sokrasins/boot-selector/README.md

# Boot Selector
 
 Choose your booting OS, now with more RP2040!

 Inspired by
