sokrasins/boot-selector/pcb/boot_main/boot_main.kicad_pcb

## KiCad design pcb/boot_main/boot_main.kicad_pcb (2024-08-22)

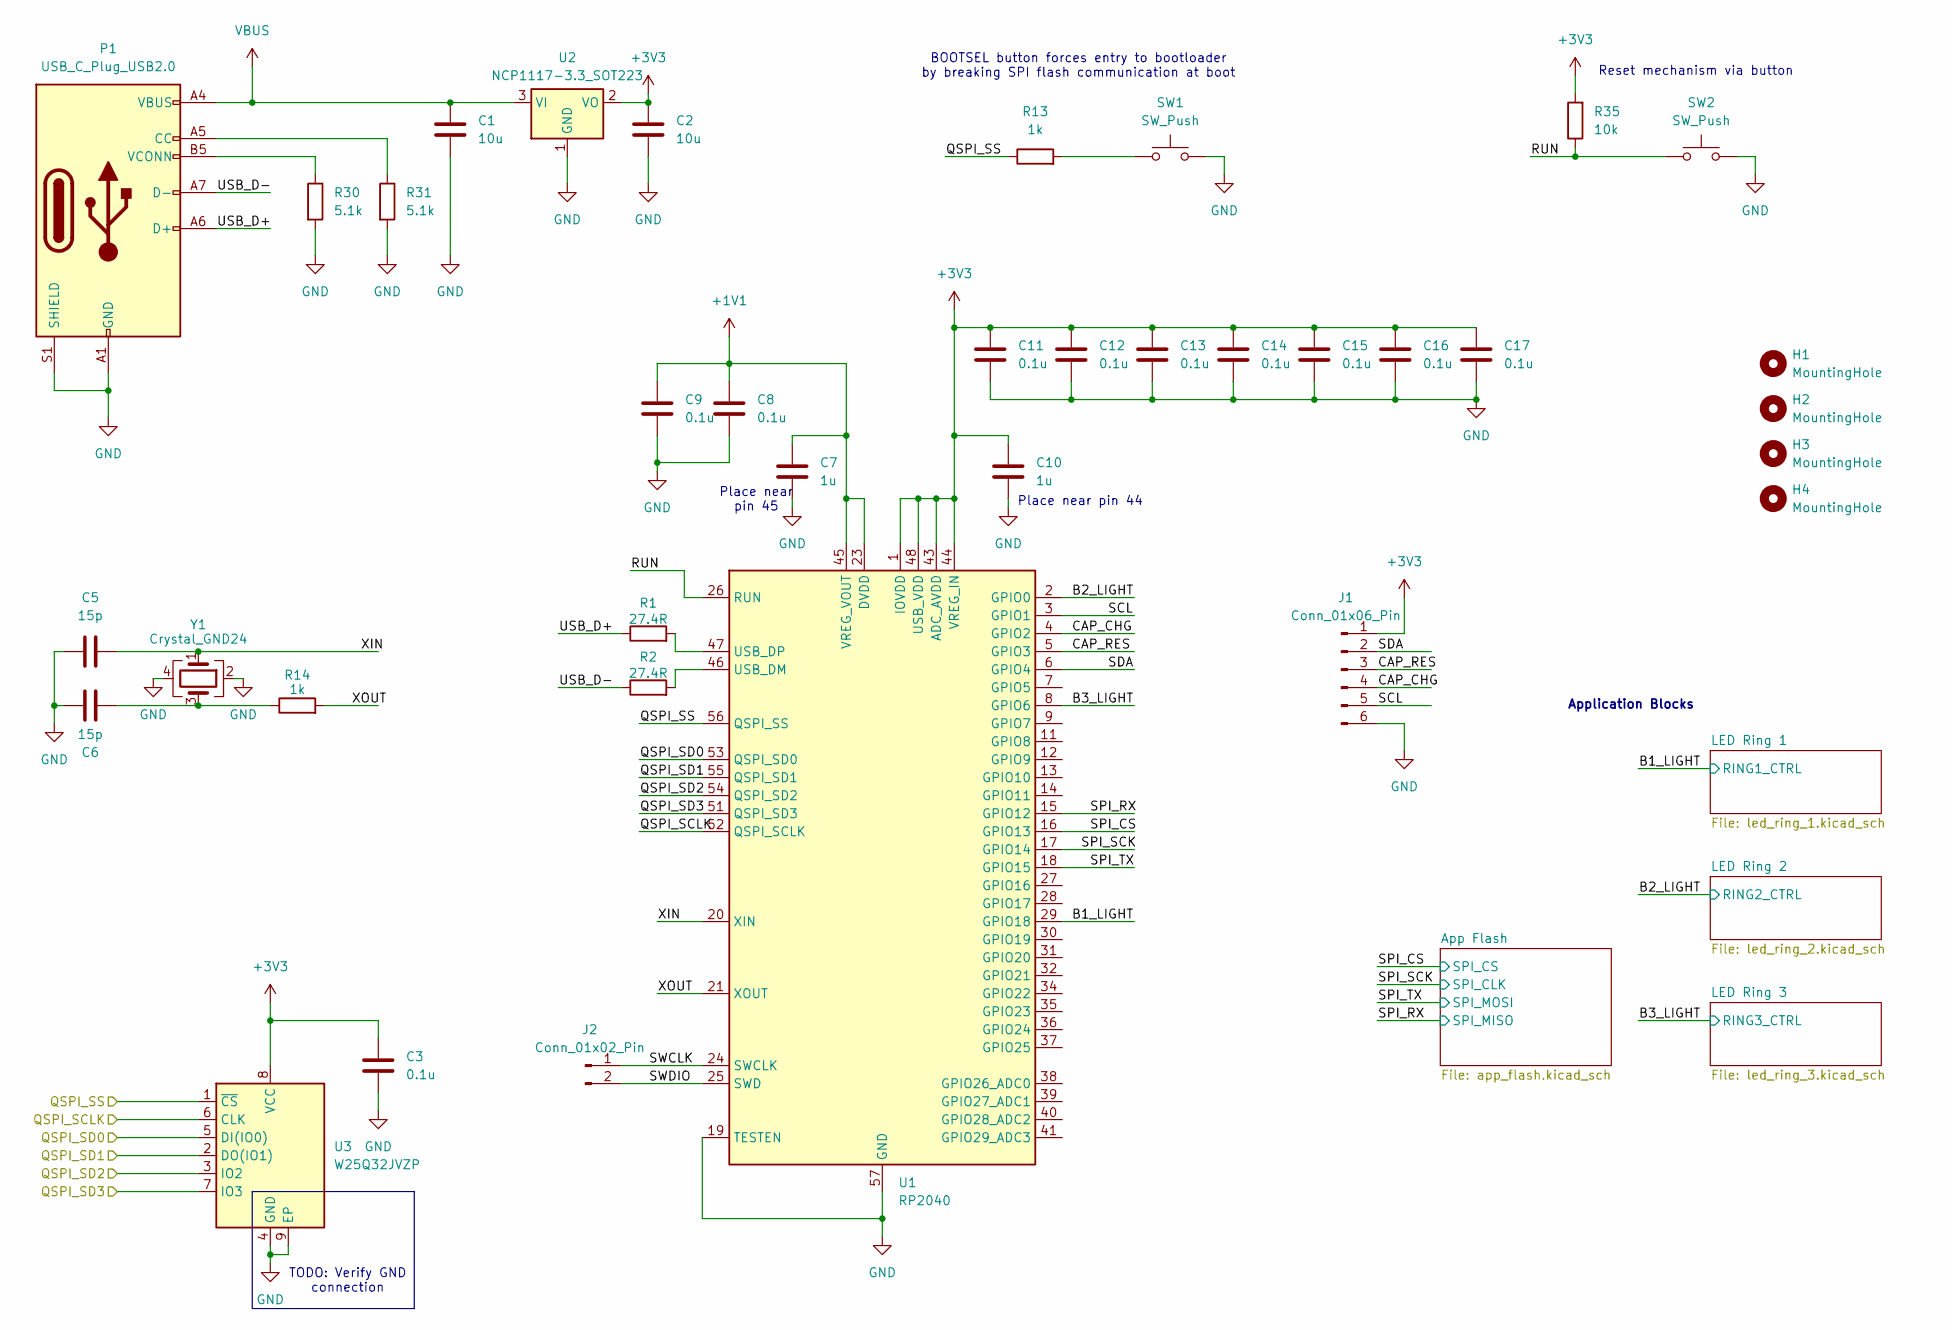
[picture p1: schematic boot_main.kicad_sch]

Parts:
C1, C2: 10u; C_0603_1608Metric
C3: 0.1u; C_0603_1608Metric
C5, C6: 15p; C_0402_1005Metric
C7, C10: 1u; C_0402_1005Metric
C8, C9, C11, C12, C13, C14, C15, C16, C17: 0.1u; C_0402_1005Metric
H1, H2, H3, H4: MountingHole; MountingHole_3.2mm_M3
J1: Conn_01x06_Pin; Hirose_FH12-6S-0.5SH_1x06-1MP_P0.50mm_Horizontal
J2: Conn_01x02_Pin; PinHeader_1x02_P2.54mm_Vertical
P1: USB_C_Plug_USB2.0; USB_C_Receptacle_GCT_USB4115-03-C
R1, R2: 27.4R; R_0402_1005Metric
R13: 1k; R_0603_1608Metric
R14: 1k; R_0402_1005Metric
R30, R31: 5.1k; R_0402_1005Metric
R35: 10k; R_0603_1608Metric
SW1, SW2: SW_Push; SW_Push_1P1T_NO_6x6mm_H9.5mm
U1: RP2040; QFN-56-1EP_7x7mm_P0.4mm_EP3.2x3.2mm
U2: NCP1117-3.3_SOT223; SOT-223-3_TabPin2
U3: W25Q32JVZP; WSON-8-1EP_6x5mm_P1.27mm_EP3.4x4.3mm
Y1: Crystal_GND24; Crystal_SMD_3225-4Pin_3.2x2.5mm

Connections:
+1V1: C7.1, C8.1, C9.1, U1.23 (DVDD), U1.45 (VREG_VOUT), U1.50 (DVDD)
+3V3: C2.1, C3.1, C10.1, C11.1, C12.1, C13.1, C14.1, C15.1, C16.1, C17.1, J1.1, R35.2, U1.1 (IOVDD), U1.10 (IOVDD), U1.22 (IOVDD), U1.33 (IOVDD), U1.42 (IOVDD), U1.43 (ADC_AVDD), U1.44 (VREG_IN), U1.48 (USB_VDD), U1.49 (IOVDD), U2.2 (VO), U3.8 (VCC); also elsewhere on the board
/B1_LIGHT: U1.29 (GPIO18); also elsewhere on the board
/B2_LIGHT: U1.2 (GPIO0); also elsewhere on the board
/B3_LIGHT: U1.8 (GPIO6); also elsewhere on the board
/CAP_CHG: J1.4, U1.4 (GPIO2)
/CAP_RES: J1.3, U1.5 (GPIO3)
/QSPI_SCLK: U1.52 (QSPI_SCLK), U3.6 (CLK)
/QSPI_SD0: U1.53 (QSPI_SD0), U3.5 (DI(IO0))
/QSPI_SD1: U1.55 (QSPI_SD1), U3.2 (DO(IO1))
/QSPI_SD2: U1.54 (QSPI_SD2), U3.3 (IO2)
/QSPI_SD3: U1.51 (QSPI_SD3), U3.7 (IO3)
/QSPI_SS: R13.1, U1.56 (QSPI_SS), U3.1 (~CS)
/RUN: R35.1, SW2.1, U1.26 (RUN)
/SCL: J1.5, U1.3 (GPIO1)
/SDA: J1.2, U1.6 (GPIO4)
/SPI_CS: U1.16 (GPIO13); also elsewhere on the board
/SPI_RX: U1.15 (GPIO12); also elsewhere on the board
/SPI_SCK: U1.17 (GPIO14); also elsewhere on the board
/SPI_TX: U1.18 (GPIO15); also elsewhere on the board
/SWCLK: J2.1, U1.24 (SWCLK)
/SWDIO: J2.2, U1.25 (SWD)
/USB_D+: P1.A6 (D+), R1.1
/USB_D-: P1.A7 (D-), R2.1
/XIN: C5.2, U1.20 (XIN), Y1.1
/XOUT: R14.2, U1.21 (XOUT)
GND: C1.2, C2.2, C3.2, C5.1, C6.1, C7.2, C8.2, C9.2, C10.2, C11.2, C12.2, C13.2, C14.2, C15.2, C16.2, C17.2, J1.6, P1.A1 (GND), P1.A12 (GND), P1.B1 (GND), P1.B12 (GND), P1.S1 (SHIELD), R30.2, R31.2, SW1.2, SW2.2, U1.19 (TESTEN), U1.57 (GND), U2.1 (GND), U3.4 (GND), U3.9 (EP), Y1.2, Y1.4; also elsewhere on the board
unnamed: C6.2, R14.1, Y1.3
unnamed: P1.A5 (CC), R31.1
unnamed: P1.B5 (VCONN), R30.1
unnamed: R13.2, SW1.1
unnamed: R2.2, U1.46 (USB_DM)
unnamed: R1.2, U1.47 (USB_DP)
VBUS: C1.1, P1.A4 (VBUS), P1.A9 (VBUS), P1.B4 (VBUS), P1.B9 (VBUS), U2.3 (VI); also elsewhere on the board

Notes on the sheet:
BOOTSEL button forces entry to bootloader by breaking SPI flash communication at boot
TODO: Verify GND connection
Place near pin 44
Place near pin 45
Reset mechanism via button
Application Blocks

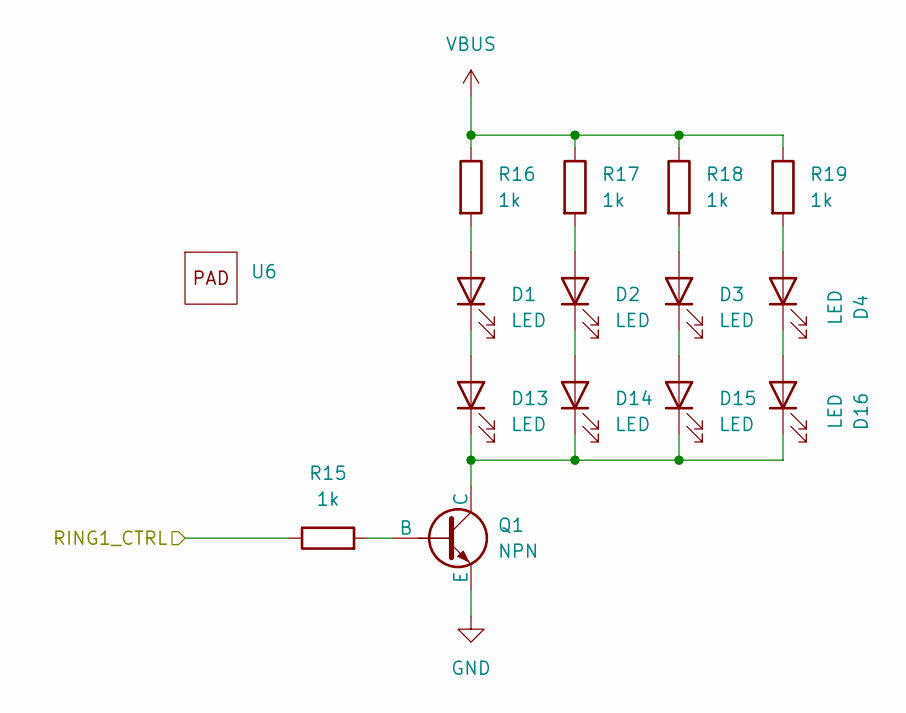
[picture p2: schematic led_ring_1.kicad_sch]

Parts:
D1, D2, D3, D4, D13, D14, D15, D16: LED; LED_1206_3216Metric
Q1: NPN; SOT-323_SC-70
R15, R16, R17, R18, R19: 1k; R_0603_1608Metric
U6: square_20x20mm_guide

Connections:
/B1_LIGHT: R15.1; also elsewhere on the board
GND: Q1.3 (E); also elsewhere on the board
unnamed: D1.2 (A), R16.2
unnamed: D1.1 (K), D13.2 (A)
unnamed: D2.2 (A), R17.2
unnamed: D3.2 (A), R18.2
unnamed: D4.2 (A), R19.2
unnamed: D13.1 (K), D14.1 (K), D15.1 (K), D16.1 (K), Q1.1 (C)
unnamed: D2.1 (K), D14.2 (A)
unnamed: D3.1 (K), D15.2 (A)
unnamed: D4.1 (K), D16.2 (A)
unnamed: Q1.2 (B), R15.2
VBUS: R16.1, R17.1, R18.1, R19.1; also elsewhere on the board

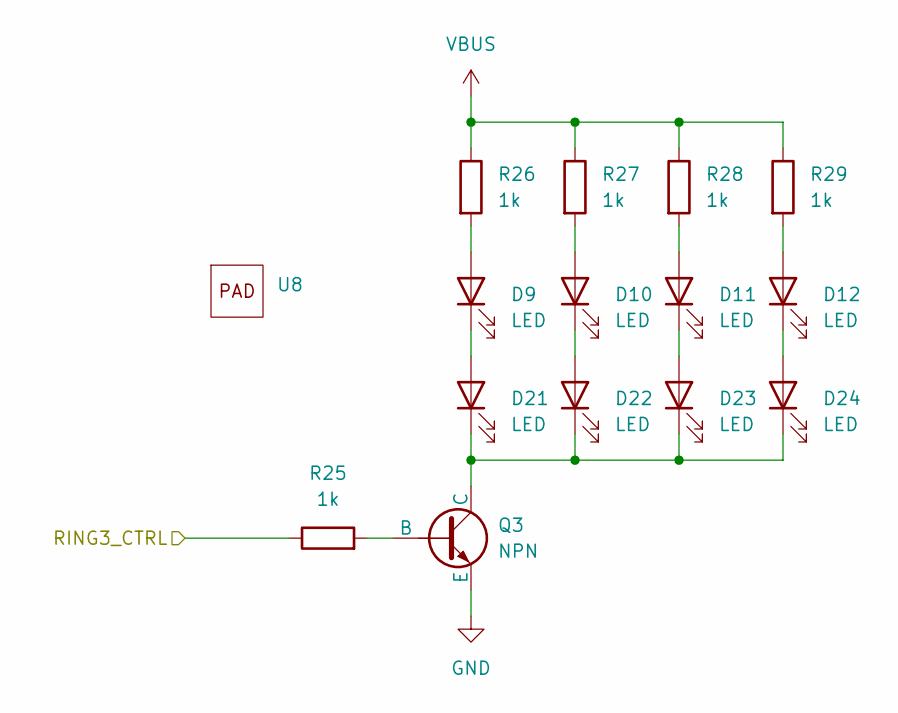
[picture p3: schematic led_ring_3.kicad_sch]

Parts:
D9, D10, D11, D12, D21, D22, D23, D24: LED; LED_1206_3216Metric
Q3: NPN; SOT-323_SC-70
R25, R26, R27, R28, R29: 1k; R_0603_1608Metric
U8: square_20x20mm_guide

Connections:
/B3_LIGHT: R25.1; also elsewhere on the board
GND: Q3.3 (E); also elsewhere on the board
unnamed: D9.2 (A), R26.2
unnamed: D10.2 (A), R27.2
unnamed: D10.1 (K), D22.2 (A)
unnamed: D11.2 (A), R28.2
unnamed: D11.1 (K), D23.2 (A)
unnamed: D12.2 (A), R29.2
unnamed: D12.1 (K), D24.2 (A)
unnamed: D9.1 (K), D21.2 (A)
unnamed: D21.1 (K), D22.1 (K), D23.1 (K), D24.1 (K), Q3.1 (C)
unnamed: Q3.2 (B), R25.2
VBUS: R26.1, R27.1, R28.1, R29.1; also elsewhere on the board

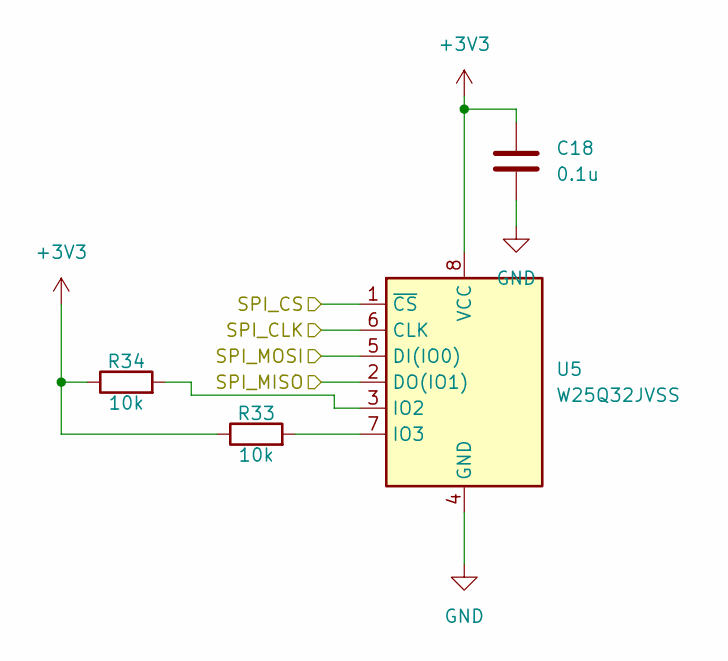
[picture p4: schematic app_flash.kicad_sch]

Parts:
C18: 0.1u; C_0603_1608Metric
R33, R34: 10k; R_0603_1608Metric
U5: W25Q32JVSS; SOIC-8_5.23x5.23mm_P1.27mm

Connections:
+3V3: C18.1, R33.1, R34.1, U5.8 (VCC); also elsewhere on the board
/SPI_CS: U5.1 (~CS); also elsewhere on the board
/SPI_RX: U5.2 (DO(IO1)); also elsewhere on the board
/SPI_SCK: U5.6 (CLK); also elsewhere on the board
/SPI_TX: U5.5 (DI(IO0)); also elsewhere on the board
GND: C18.2, U5.4 (GND); also elsewhere on the board
unnamed: R34.2, U5.3 (IO2)
unnamed: R33.2, U5.7 (IO3)

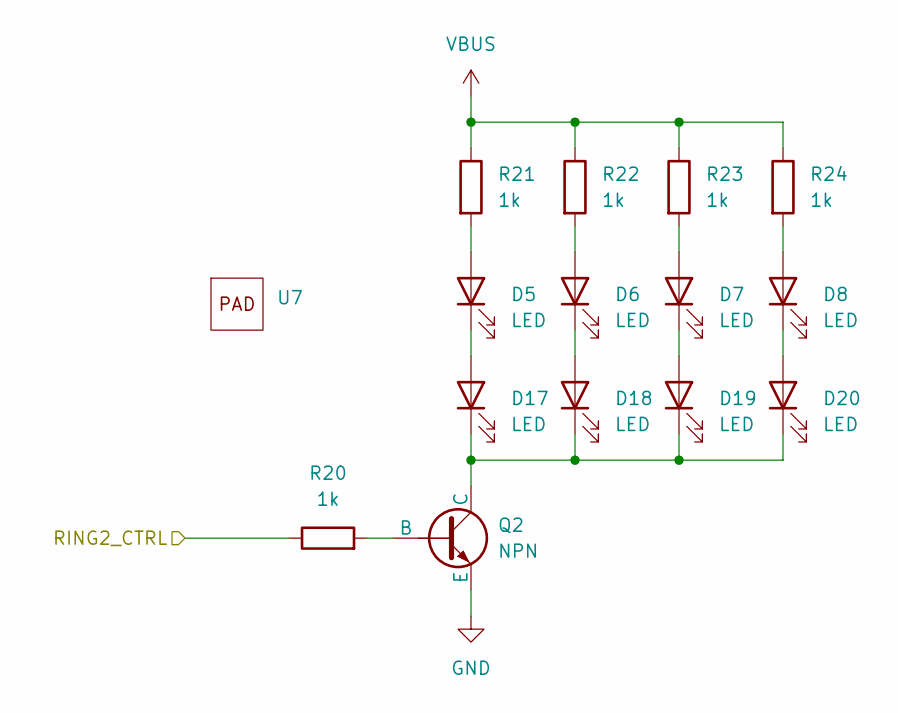
[picture p5: schematic led_ring_2.kicad_sch]

Parts:
D5, D6, D7, D8, D17, D18, D19, D20: LED; LED_1206_3216Metric
Q2: NPN; SOT-323_SC-70
R20, R21, R22, R23, R24: 1k; R_0603_1608Metric
U7: square_20x20mm_guide

Connections:
/B2_LIGHT: R20.1; also elsewhere on the board
GND: Q2.3 (E); also elsewhere on the board
unnamed: D5.2 (A), R21.2
unnamed: D6.2 (A), R22.2
unnamed: D7.2 (A), R23.2
unnamed: D8.2 (A), R24.2
unnamed: D5.1 (K), D17.2 (A)
unnamed: D17.1 (K), D18.1 (K), D19.1 (K), D20.1 (K), Q2.1 (C)
unnamed: D6.1 (K), D18.2 (A)
unnamed: D7.1 (K), D19.2 (A)
unnamed: D8.1 (K), D20.2 (A)
unnamed: Q2.2 (B), R20.2
VBUS: R21.1, R22.1, R23.1, R24.1; also elsewhere on the board

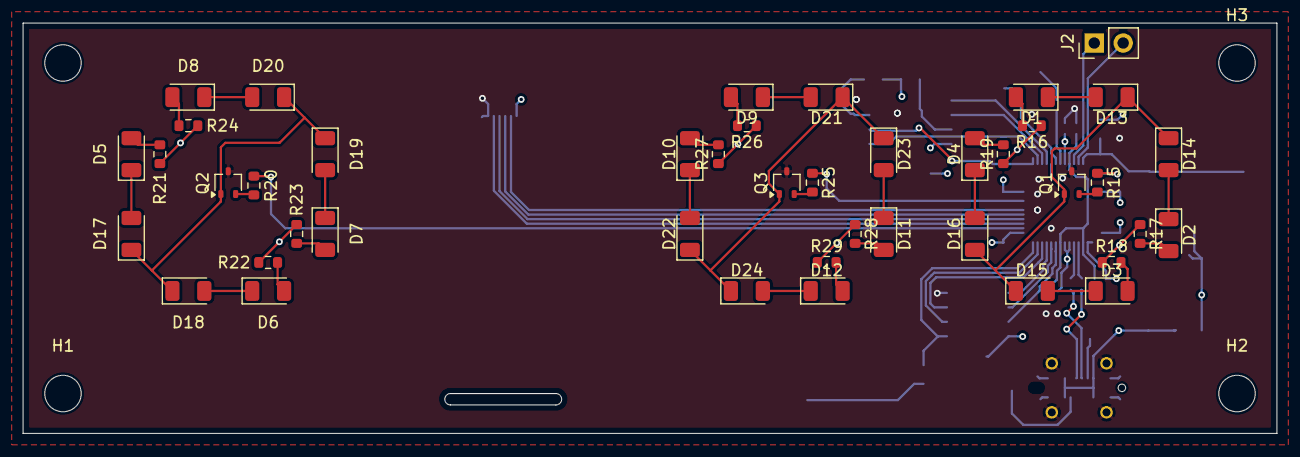
[picture p6: board boot_main.kicad_pcb from above]

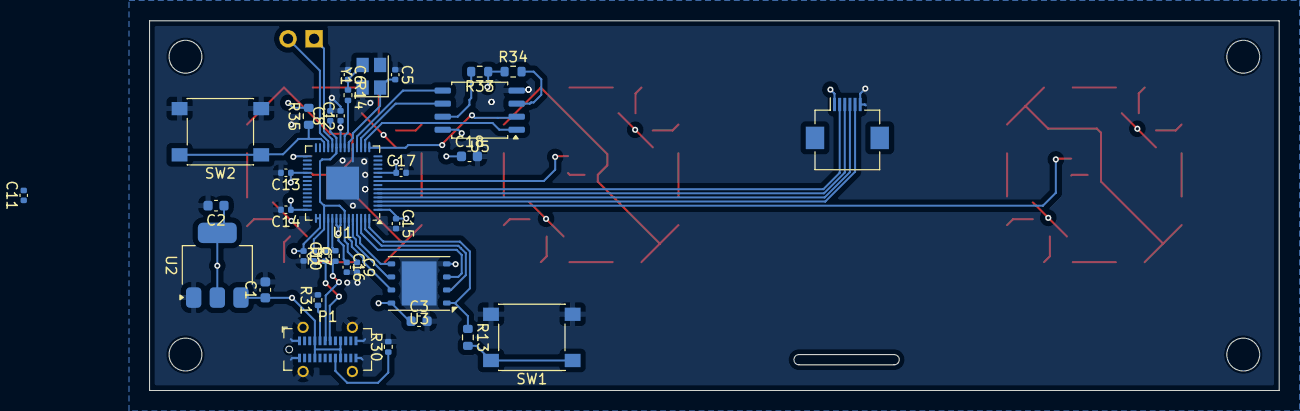
[picture p7: board boot_main.kicad_pcb from below]

Board: 4 copper layers, 110.0 x 36.0 mm, 85 parts (35 on the bottom side), 66 nets.
