sokrasins/boot-selector/pcb/boot_panel/boot_panel.kicad_pcb

## KiCad design pcb/boot_panel/boot_panel.kicad_pcb (2024-08-07)

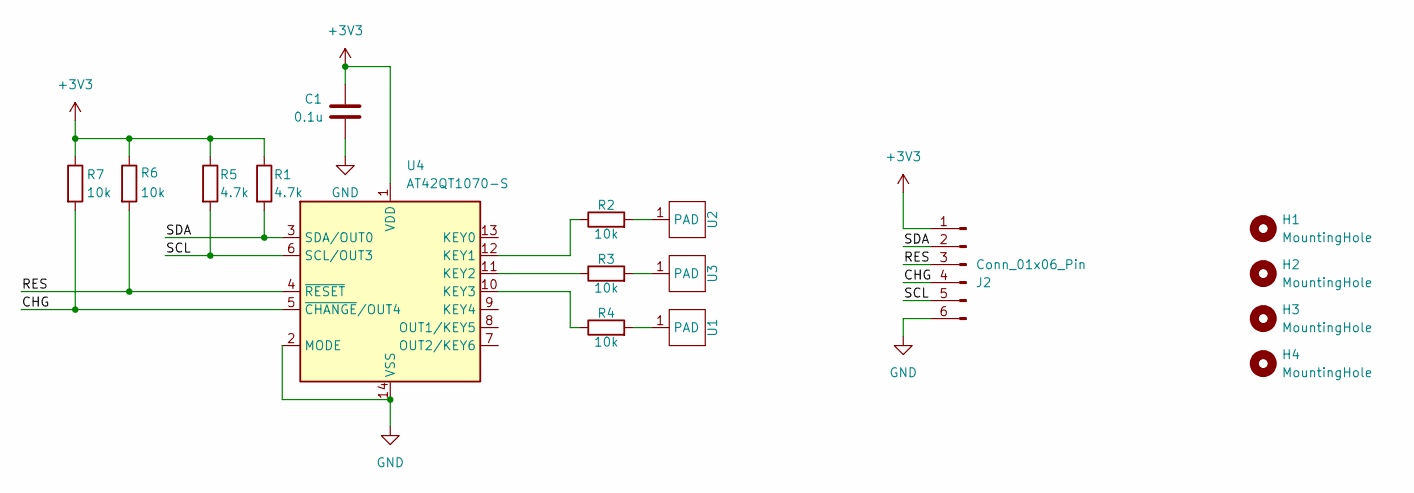
[picture p8: schematic boot_panel.kicad_sch]

Parts:
C1: 0.1u; C_0603_1608Metric_Pad1.08x0.95mm_HandSolder
H1, H2, H3, H4: MountingHole; MountingHole_3.2mm_M3
J2: Conn_01x06_Pin; Hirose_FH12-6S-0.5SH_1x06-1MP_P0.50mm_Horizontal
R1, R5: 4.7k; R_0603_1608Metric_Pad0.98x0.95mm_HandSolder
R2, R3, R4, R6, R7: 10k; R_0603_1608Metric_Pad0.98x0.95mm_HandSolder
U1, U2, U3: square_20x20mm
U4: AT42QT1070-S; SOIC-14_3.9x8.7mm_P1.27mm

Connections:
+3V3: C1.1, J2.1, R1.1, R5.1, R6.1, R7.1, U4.1 (VDD)
/CHG: J2.4, R7.2, U4.5 (~CHANGE/OUT4)
/RES: J2.3, R6.2, U4.4 (~RESET)
/SCL: J2.5, R5.2, U4.6 (SCL/OUT3)
/SDA: J2.2, R1.2, U4.3 (SDA/OUT0)
GND: C1.2, J2.6, U4.2 (MODE), U4.14 (VSS)
unnamed: R4.2, U1.1 (PAD)
unnamed: R2.2, U2.1 (PAD)
unnamed: R3.2, U3.1 (PAD)
unnamed: R2.1, U4.12 (KEY1)
unnamed: R3.1, U4.11 (KEY2)
unnamed: R4.1, U4.10 (KEY3)

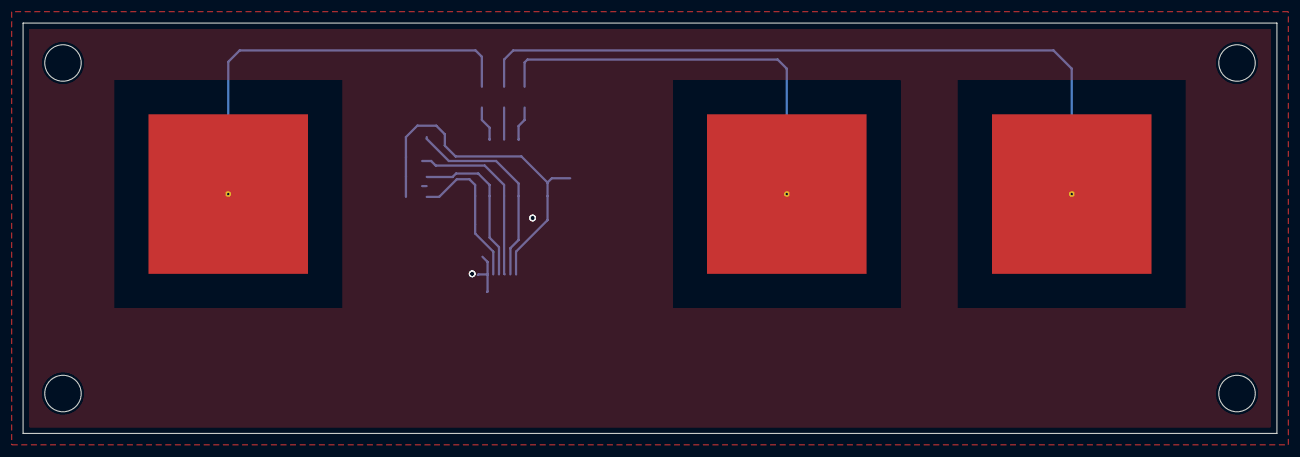
[picture p9: board boot_panel.kicad_pcb from above]

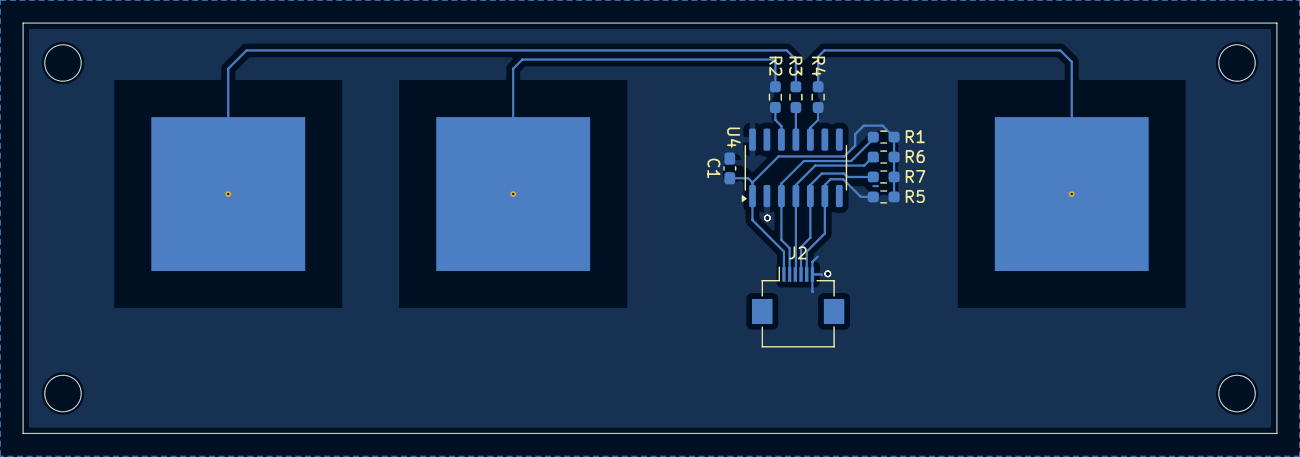
[picture p10: board boot_panel.kicad_pcb from below]

Board: 2 copper layers, 110.0 x 36.0 mm, 17 parts (10 on the bottom side), 12 nets.
