sokrasins/boot-selector/firmware/src/main.c

/* 
 * The MIT License (MIT)
 *
 * Copyright (c) 2019 Ha Thach (tinyusb.org)
 *
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
 */

#include <stdlib.h>
#include <stdio.h>
#include <string.h>

#include "bsp/board.h"
#include "msc_disk.h"
#include "console.h"
#include "boot_switch.h"
#include "reboot.h"
#include "cap_sense.h"
#include "keys.h"
#include "bsp.h"
#include "settings.h"


/*------------- MAIN -------------*/
int main(void)
{
    board_init();
    boot_switch_init();

    // Set the file to serve at boot
    settings_os_t choice = settings_read_os();
    msc_set_file(choice);

    // Init device stack on configured roothub port
    tud_init(BOARD_TUD_RHPORT);

    // Set up the keys
    key_1_init();
    key_2_init();
    
    sleep_ms(1000);

    cap_sense_init();
    cap_sense_reg_cb(key_cap_cb);

    while (1)
    {
        tud_task(); // tinyusb device task
        console_cdc_task(); // Consume console activity
        cap_sense_task(); // Check for changes in cap sense
        sleep_ms(10);
    }

    return 0;
}
