sokrasins/boot-selector/firmware/src/cap_sense/cap_sense.h

#ifndef CAP_SENSE_H_
#define CAP_SENSE_H_

#include "status.h"
#include <stdint.h>

typedef enum {
    CAP_SENSE_KEY_1 = 0,
    CAP_SENSE_KEY_2,
    CAP_SENSE_KEY_3,
    CAP_SENSE_KEY_4,
    CAP_SENSE_KEY_MAX,
    CAP_SENSE_KEY_INVALID,
} cap_sense_key_t;

typedef enum {
    CAP_SENSE_EVT_KEY_OFF,
    CAP_SENSE_EVT_KEY_ON,
} cap_sense_evt_t;

typedef void (*cap_sense_cb_t)(cap_sense_key_t key, cap_sense_evt_t evt, void *data);

status_t cap_sense_init(void);

void cap_sense_task(void);

status_t cap_sense_reg_cb(cap_sense_cb_t cb);

uint8_t cap_get_major(void);

uint8_t cap_get_minor(void);

uint8_t cap_get_version(void);

#endif /*CAP_SENSE_H_*/
