sokrasins/boot-selector/(commit log)

2024-07-30 reorg, added maindboard sch
    [boot_main.kicad_pcb, boot_main.kicad_sch]
2024-08-01 More schematic
    [boot_main.kicad_sch]
2024-08-02 More sch, added datasheets
    [app_flash.kicad_sch, boot_main.kicad_sch, cap_sense.kicad_sch, led_ring_1.kicad_sch, led_ring_2.kicad_sch, led_ring_3.kicad_sch]
2024-08-02 Add cap sense driver
2024-08-03 Assign footprints
    [app_flash.kicad_sch, boot_main.kicad_sch, cap_sense.kicad_sch, led_ring_1.kicad_sch, led_ring_2.kicad_sch, led_ring_3.kicad_sch]
2024-08-03 push parts around
    [boot_main.kicad_pcb, boot_main.kicad_sch, cap_sense.kicad_sch]
2024-08-03 Some initial layout
    [boot_main.kicad_pcb, boot_main.kicad_sch, cap_sense.kicad_sch]
2024-08-03 Added front panel board
    [boot_panel.kicad_pcb, boot_panel.kicad_sch]
2024-08-04 move panel connector to fpc
    [boot_panel.kicad_pcb, boot_panel.kicad_sch]
2024-08-05 MOre layout
    [boot_main.kicad_pcb, boot_main.kicad_sch, boot_panel.kicad_pcb, boot_panel.kicad_sch, cap_sense.kicad_sch, led_ring_1.kicad_sch, led_ring_2.kicad_sch, led_ring_3.kicad_sch]
2024-08-06 move cap sense ic to front panel
    [boot_main.kicad_pcb, boot_main.kicad_sch, boot_panel.kicad_pcb, boot_panel.kicad_sch, cap_sense.kicad_sch]
2024-08-17 Tweak i2c settings
2024-08-17 Change voltage rail on LEDs
    [boot_main.kicad_pcb, led_ring_1.kicad_sch, led_ring_2.kicad_sch, led_ring_3.kicad_sch]
2024-08-22 Basic communication with the cap sensor
2024-08-22 Toggle switch function working
2024-08-22 Flash storage doesn't work, but bouncing USB connection does
    [boot_switch.c, bsp_pindef.h, cap_sense.h, console.c, main.c, settings.c, settings.h]
